vascoguita/fmc-delay-1ns-8cha/README.md

<!--
SPDX-FileCopyrightText: 2022 CERN (home.cern)

SPDX-License-Identifier: CC-BY-SA-4.0+
-->

This repo contains the full source code (hardware + gateware + software) for the FmcDelay1ns4cha FMC module.
