vascoguita/fmc-delay-1ns-8cha/doc/index.rst

Welcome to Fmc Fine-Delay Software's documentation!
===================================================

.. toctree::
   :maxdepth: 2
   :caption: Contents:

   introduction
   installation
   driver
   library
   tools
   developer-info
   troubleshooting
