vascoguita/fmc-delay-1ns-8cha/hardware/doc/long-term-report/drawings/delay_vs_temp.pdf

0

0.2

65.6 | 65.8 | 66 | 66.2 | 66.4 | 66.6 | 66.8 | 67

Delay error [ns]

Temperature [deg C]

Delay error
