vascoguita/fmc-delay-1ns-8cha/hardware/doc/long-term-report/drawings/jitter_histogram.pdf

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
-0.5 | -0.3 | -0.1 | 0.1 | 0.3 | 0.5

Sample count

Time [ns]

Error wrs to 700 ns setpoint
