vascoguita/fmc-delay-1ns-8cha/hardware/doc/design-notes/drawings/output_shape.png

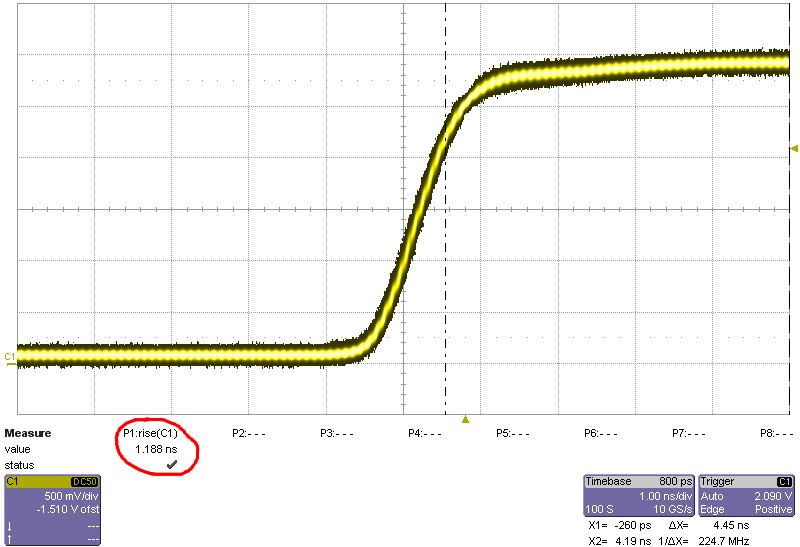
hardware/doc/design-notes/drawings/output_shape.png
