vascoguita/fmc-delay-1ns-8cha/hardware/doc/design-notes/drawings/top_level.png

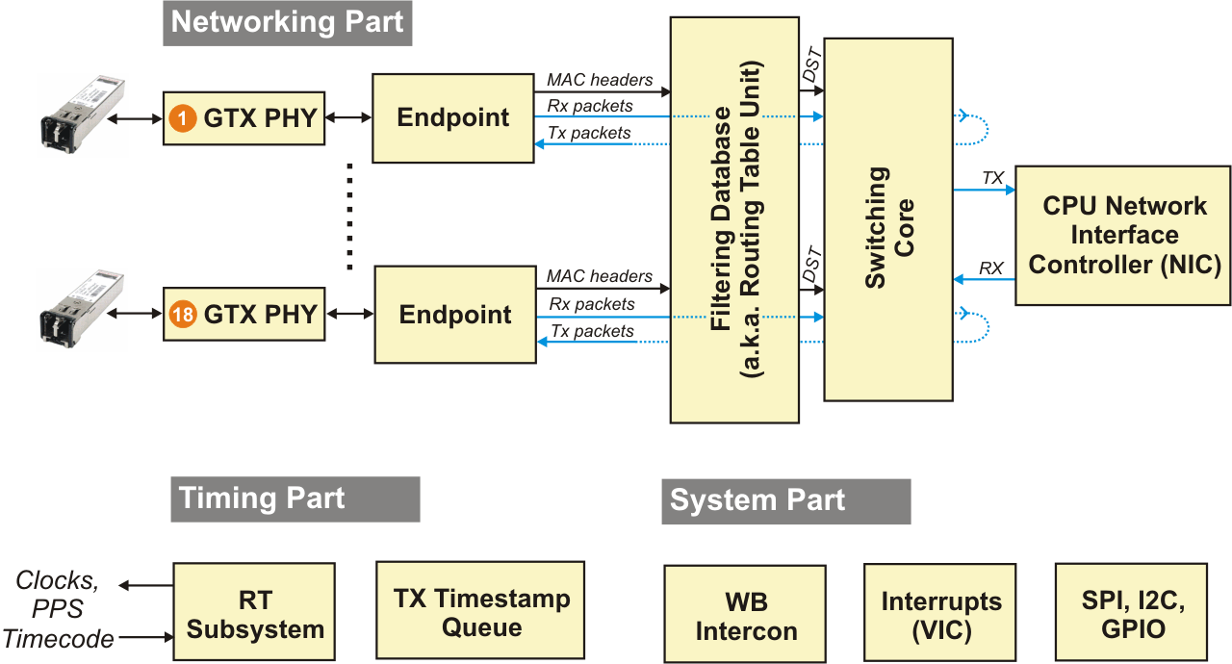
hardware/doc/design-notes/drawings/top_level.png
