vascoguita/fmc-delay-1ns-8cha/hardware/mechanical/heatsink/FMC-Delay Heatsink.stp

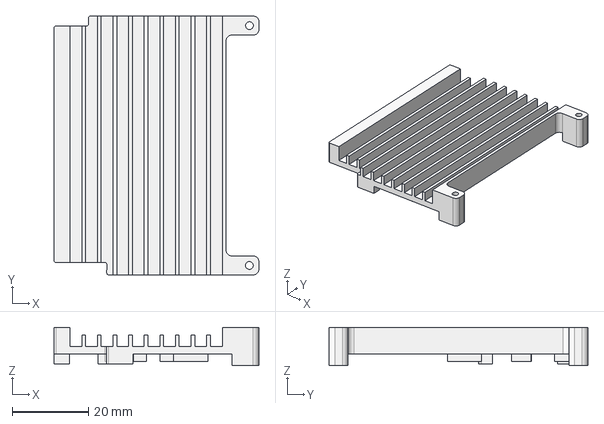
[picture p3: CAD file, 2014-09-23]
hardware/mechanical/heatsink/FMC-Delay Heatsink.stp
53.9 x 68.0 x 10.0 mm
