vascoguita/fmc-delay-1ns-8cha/(list of files, cad)

Other CAD files:
hardware/mechanical/heatsink/FMC-Delay Heatsink.dxf
hardware/mechanical/heatsink/FMC-Delay Heatsink.igs
