vascoguita/fmc-delay-1ns-8cha/hardware/doc/long-term-report/drawings/plot_average.pdf

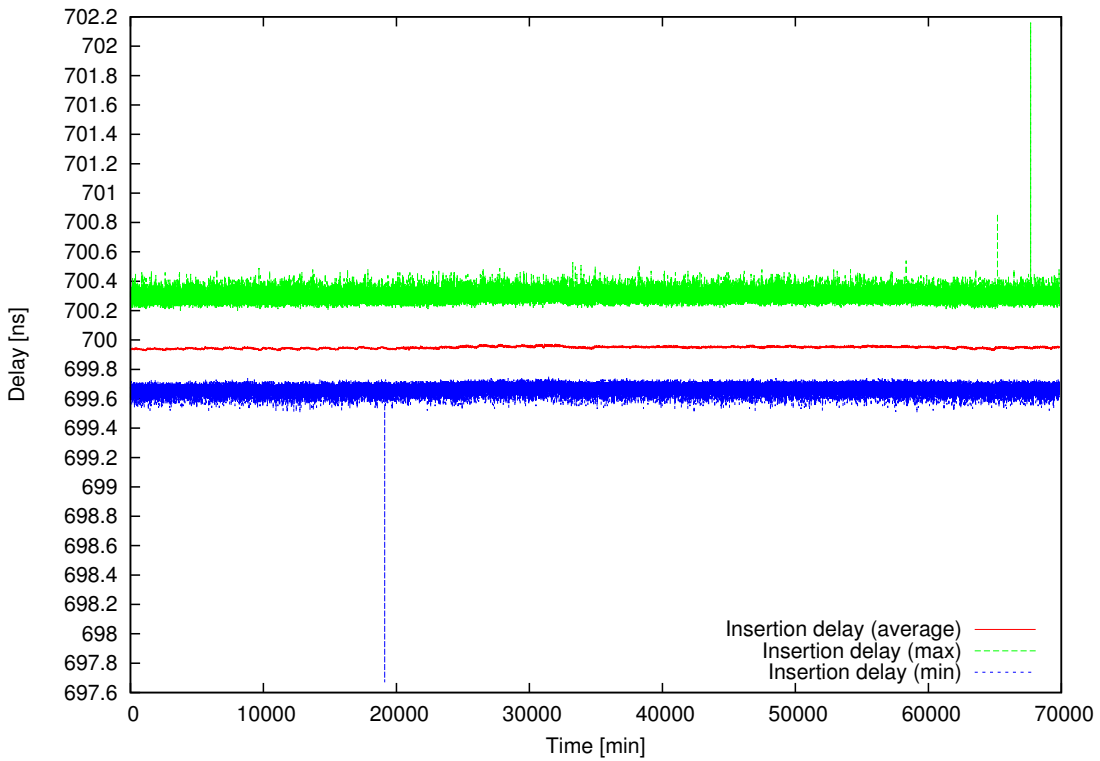
[picture p4: page 1]
Delay [ns]; Time [min]

Insertion delay (average)
Insertion delay (max)
Insertion delay (min)
