vascoguita/fmc-delay-1ns-8cha/hardware/doc/long-term-report/drawings/connection_diagram.pdf

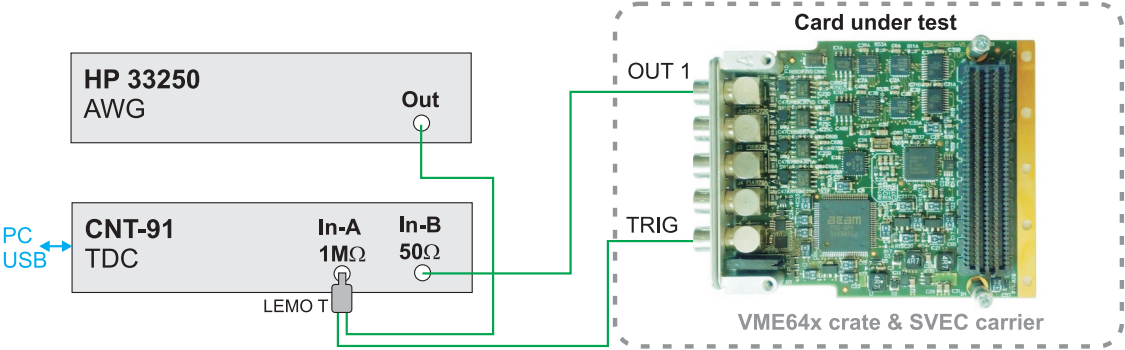
[picture p5: page 1]
