vascoguita/fmc-delay-1ns-8cha/hardware/doc/design-notes/drawings/block_diagram.pdf

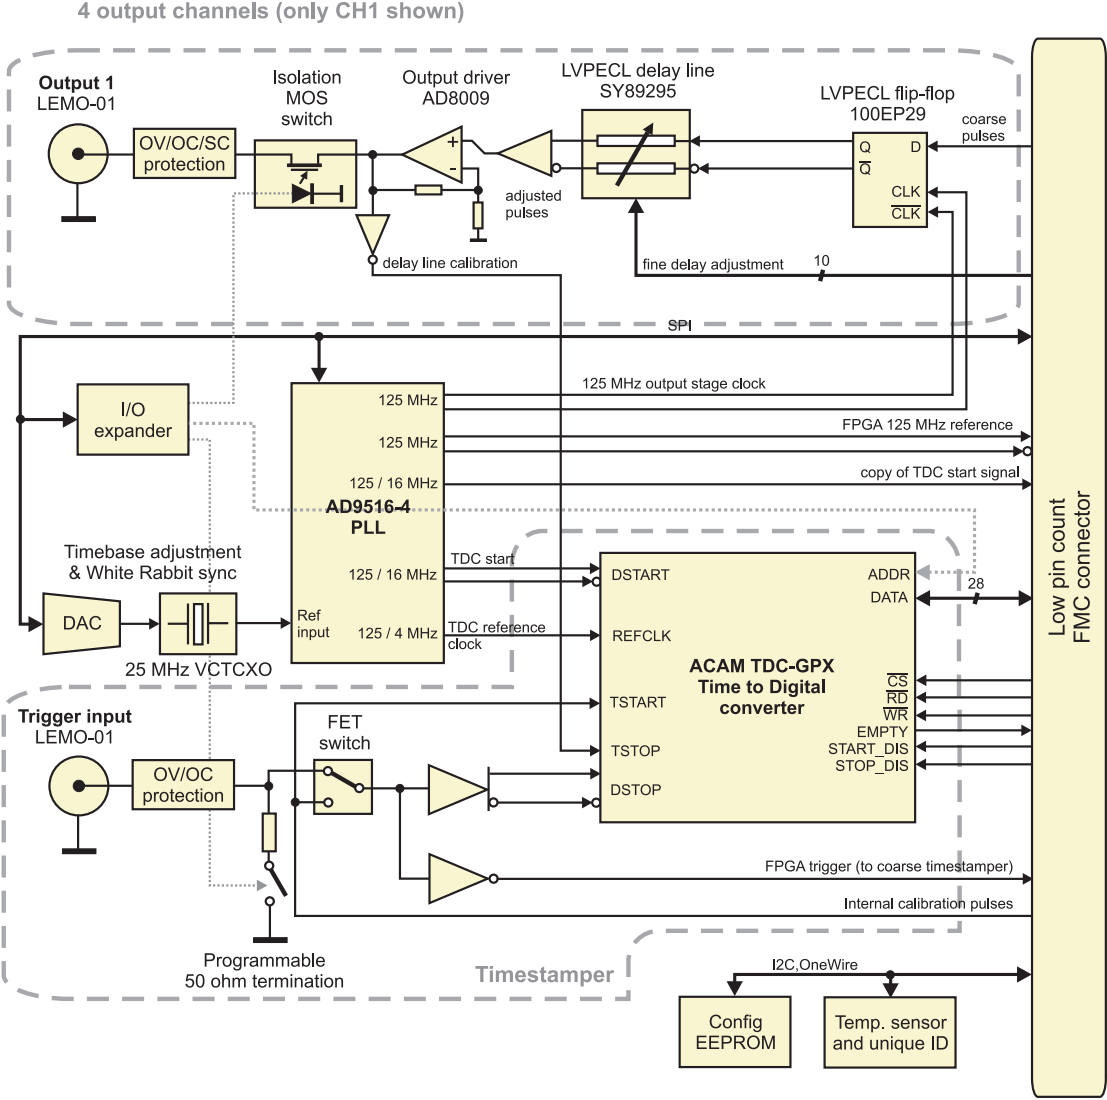
[picture p6: page 1]
