vascoguita/fmc-delay-1ns-8cha/hardware/doc/design-notes/drawings/calib_why.pdf

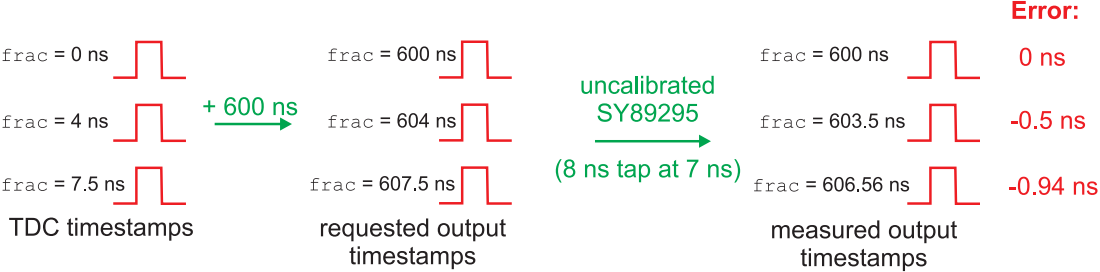
[picture p7: page 1]
