vascoguita/fmc-delay-1ns-8cha/hardware/doc/design-notes/drawings/vhdl_output_stage.pdf

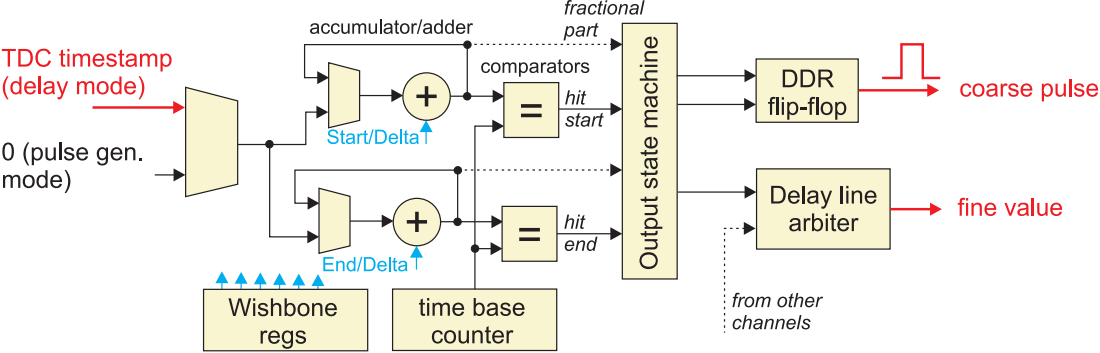
[picture p8: page 1]
