vascoguita/fmc-delay-1ns-8cha/hardware/doc/design-notes/drawings/svec_top_block.pdf

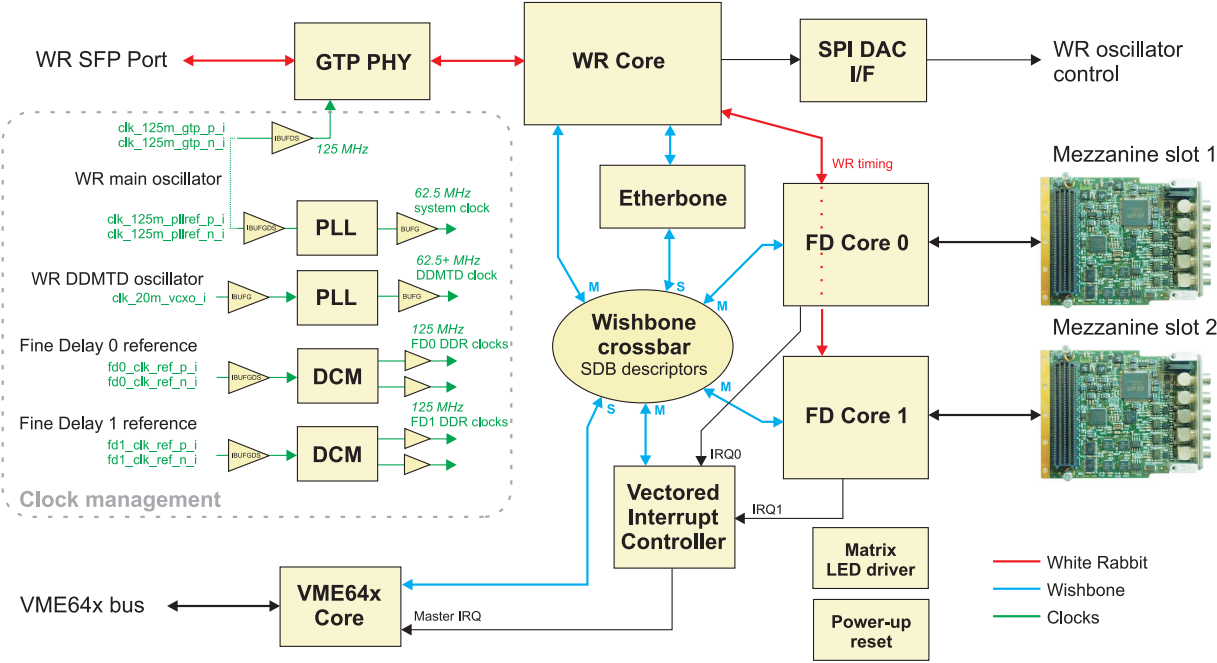
[picture p9: page 1]
