vascoguita/fmc-delay-1ns-8cha/hardware/doc/design-notes/drawings/tdc_timebase.pdf

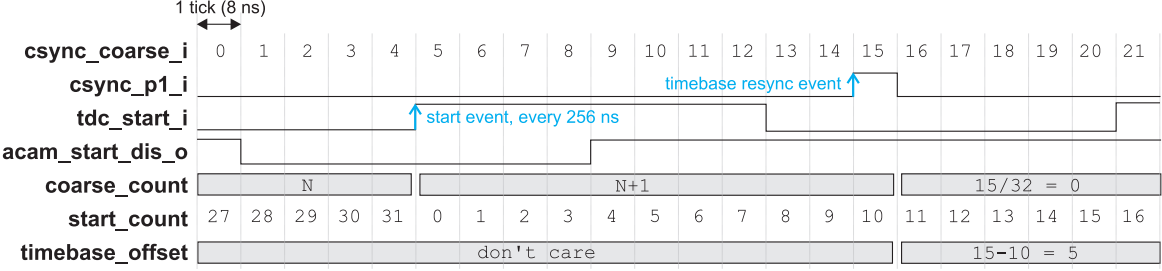
[picture p10: page 1]
