vascoguita/fmc-delay-1ns-8cha/hardware/doc/design-notes/drawings/ddmtd_calibration.pdf

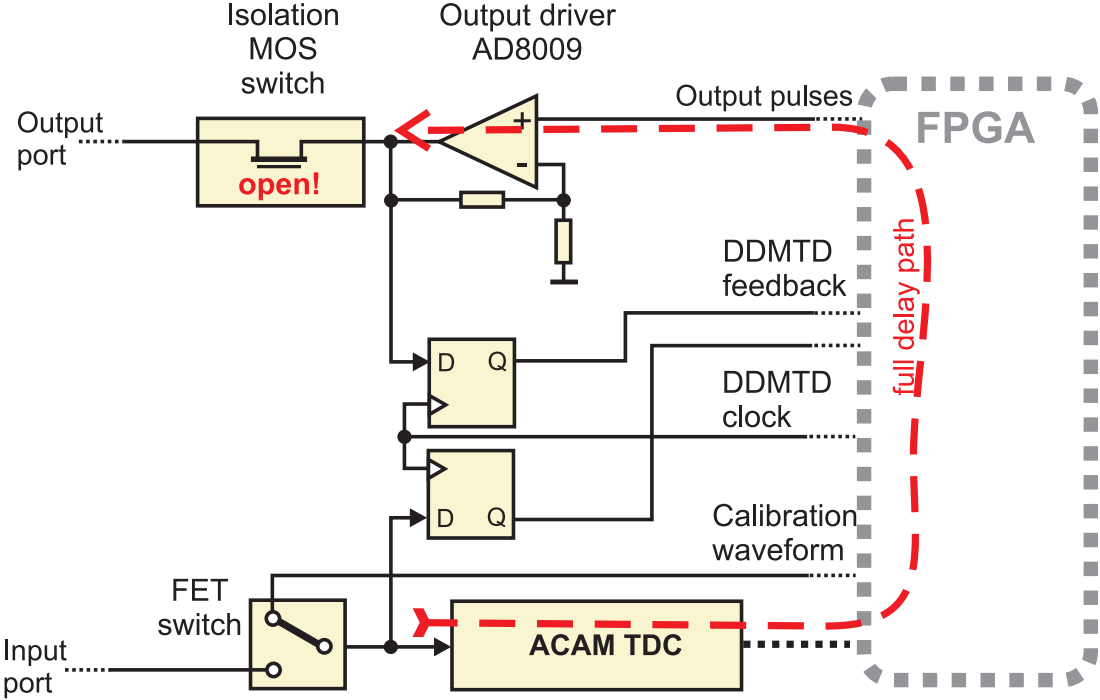
[picture p11: page 1]
