vascoguita/fmc-delay-1ns-8cha/hardware/doc/design-notes/drawings/fpga_diagram.pdf

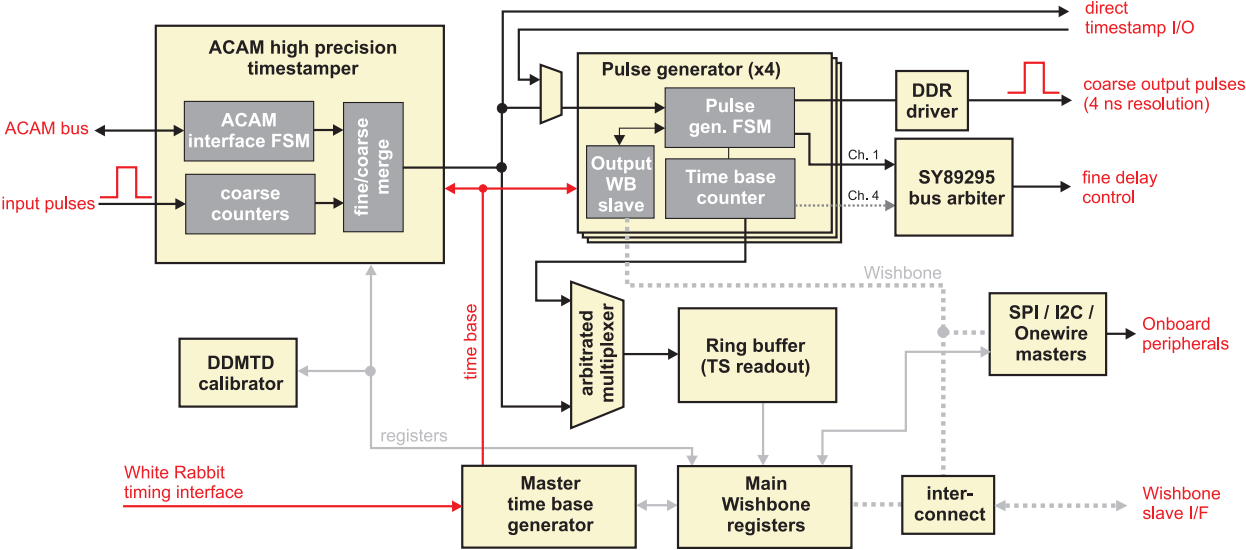
[picture p12: page 1]
