vascoguita/fmc-delay-1ns-8cha/hardware/doc/design-notes/drawings/output_calibration.pdf

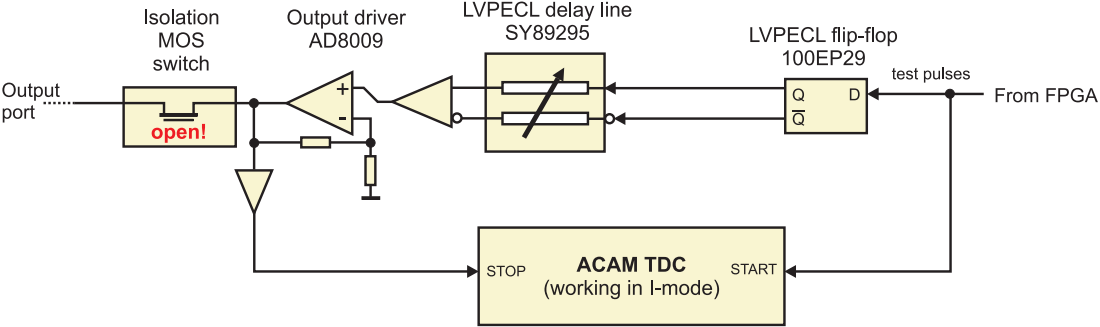
[picture p13: page 1]
