vascoguita/fmc-delay-1ns-8cha/hardware/doc/design-notes/drawings/simple_diagram.pdf

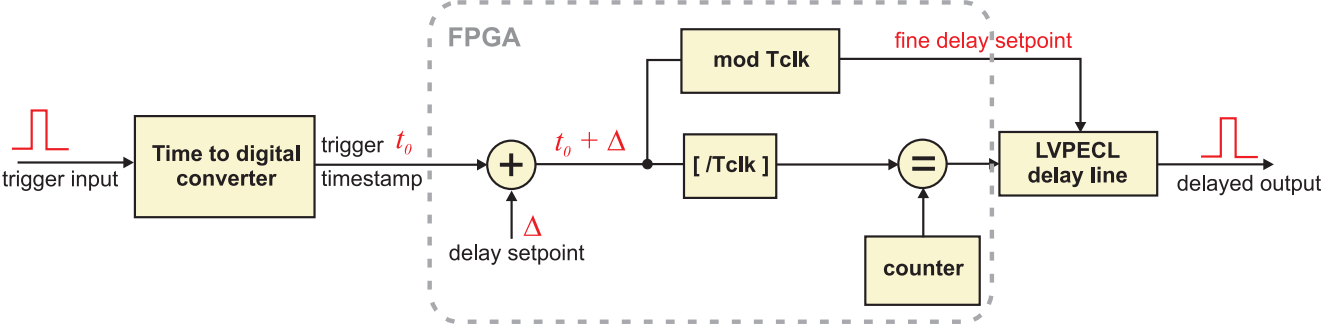
[picture p14: page 1]
