vascoguita/fmc-delay-1ns-8cha/hardware/doc/design-notes/drawings/tdc_principle.pdf

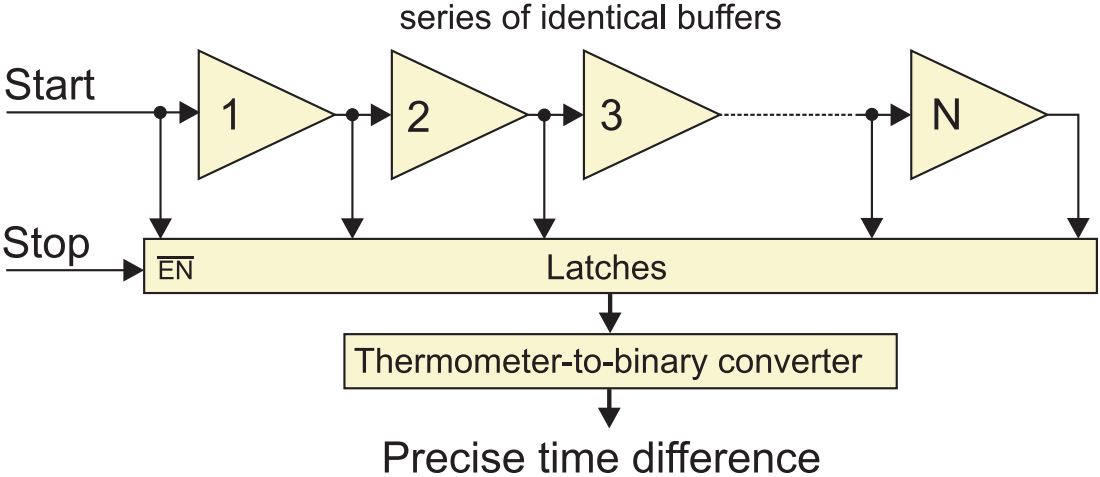
[picture p15: page 1]
