vascoguita/fmc-delay-1ns-8cha/hardware/doc/design-notes/drawings/wr_pll.pdf

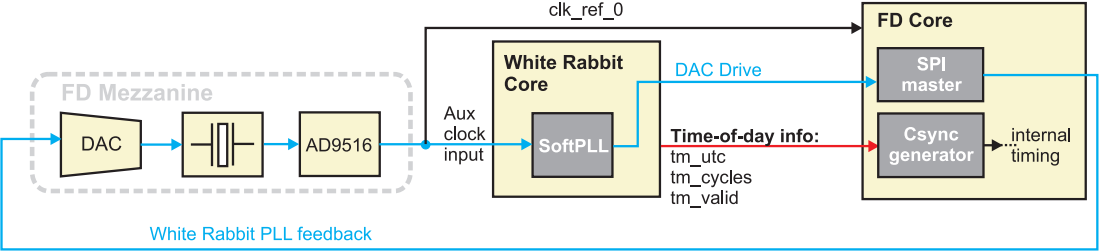
[picture p16: page 1]
