vascoguita/fmc-delay-1ns-8cha/(list of files, drawings)

Other design files:
hardware/circuit_board/EDA-02267-V6-1_project.PrjPCB
hardware/circuit_board/Schematics/acam_tdc.SchDoc
hardware/circuit_board/Schematics/clock_generator.SchDoc
hardware/circuit_board/Schematics/delay_channel.SchDoc
hardware/circuit_board/Schematics/drv_single_channel.SchDoc
hardware/circuit_board/Schematics/fmc_connector.SchDoc
hardware/circuit_board/Schematics/FMC_Delay_1ns_4Cha.SchDoc
hardware/circuit_board/Schematics/input_stage.SchDoc
hardware/circuit_board/Schematics/leds_mem_sensor.SchDoc
hardware/circuit_board/Schematics/output_driver.SchDoc
hardware/circuit_board/Schematics/power_supply.SchDoc
