vascoguita/fmc-delay-1ns-8cha/hdl/testbench/spec_wr_top/Manifest.py

# SPDX-FileCopyrightText: 2022 CERN (home.cern)
#
# SPDX-License-Identifier: CERN-OHL-W-2.0+

ctrls = ["bank3_32b_32b"]
action = "simulation"
target = "xilinx"
vcom_opt="-mixedsvvh l"
fetchto = "../../ip_cores"
include_dirs = ["../../include",
                "../../ip_cores/general-cores/modules/wishbone/wb_spi/",
                "../../ip_cores/general-cores/sim/",
                "../../ip_cores/gn4124-core/hdl/sim/gn4124_bfm/",
                "../../ip_cores/general-cores/modules/wishbone/wb_lm32/src/"]
syn_device = "xc6slx45t"
sim_tool = "modelsim"
sim_top = "main"
top_module = "main"
files = ["main.sv","buildinfo_pkg.vhd","../../syn/spec/sourceid_spec_fine_delay_top_pkg.vhd"]

modules = {"local":  ["../../top/spec",    "../../ip_cores/gn4124-core/hdl/sim/gn4124_bfm/" ]}

#try:
exec(open(fetchto + "/general-cores/tools/gen_buildinfo.py").read())
#except:
#  pass
