vascoguita/fmc-delay-1ns-8cha/hdl/testbench/adder_test/Manifest.py

# SPDX-FileCopyrightText: 2022 CERN (home.cern)
#
# SPDX-License-Identifier: CERN-OHL-W-2.0+

action = "simulation"

vlog_opt="+incdir+../../include"

files = ["main.sv", "../../rtl/fd_ts_adder.vhd"];
#files = "../modules = {"local": [ "../../rtl" ] }
