vascoguita/fmc-delay-1ns-8cha/(commit log)

2011-08-29 Separated reset generation from the top-level core
    [fd_reset_generator.vhd]
2011-08-29 Separated GPIO port driver from the top-level core
2011-08-29 fd_acam_timestamper: pipelined post-processing, replaced some constants with host-driven registers
    [fd_acam_timestamper.vhd]
2011-08-31 fd_reset_generator: naming fixes after moving the code to a separate unit
    [fd_reset_generator.vhd]
2011-08-31 fd_acam_timestamper: moved some code to separate units, fixed a bug causing coarse timestamp to be sometimes gathered before the ACAM gets enabled
    [fd_acam_timestamper.vhd]
2011-09-06 Sch/PCB: Initial upload
    [CHANNEL_DELAY.SchDoc, FMC connector.SchDoc, FMC_Delay_1ns_4Cha.PrjPcb, FMC_Delay_1ns_4Cha.SchDoc, INPUT_LOGIC.SchDoc, TDC.SchDoc, clock_generator.SchDoc]
2011-09-06 Sch/PCB: wip 1
    [CHANNEL_DELAY.SchDoc, FMC connector.SchDoc, FMC_Delay_1ns_4Cha.PrjPcb, FMC_Delay_1ns_4Cha.SchDoc, INPUT_LOGIC.SchDoc, LED_MEM.SchDoc, OUTPUT_BUFFER.SchDoc, TDC.SchDoc]
2011-09-06 Sch/PCB: wip 2
    [FMC connector.SchDoc, FMC_Delay_1ns_4Cha.PrjPcb, clock_generator.SchDoc]
2011-09-06 Sch/PCB: wip 3
    [CHANNEL_DELAY.SchDoc, FMC connector.SchDoc, FMC_Delay_1ns_4Cha.PrjPcb, FMC_Delay_1ns_4Cha.SchDoc, INPUT_LOGIC.SchDoc, LED_MEM.SchDoc, OUTPUT_BUFFER.SchDoc, TDC.SchDoc]
2011-09-06 Sch/PCB: wip 4
    [CHANNEL_DELAY.SchDoc, FMC_Delay_1ns_4Cha.SchDoc, INPUT_LOGIC.SchDoc, LED_MEM.SchDoc, OUTPUT_BUFFER.SchDoc, TDC.SchDoc, power_supply.SchDoc]
2011-09-06 Sch/PCB: wip 5
    [CHANNEL_DELAY.SchDoc, FMC connector.SchDoc, FMC_Delay_1ns_4Cha.PrjPcb, FMC_Delay_1ns_4Cha.SchDoc, INPUT_LOGIC.SchDoc, LED_MEM.SchDoc, OUTPUT_BUFFER.SchDoc, TDC.SchDoc]
2011-09-06 Sch/PCB: ReviewFineDelayFMC10112010 Improvements
    [CHANNEL_DELAY.SchDoc, FMC connector.SchDoc, FMC_Delay_1ns_4Cha.SchDoc, INPUT_LOGIC.SchDoc, LED_MEM.SchDoc, OUTPUT_BUFFER.SchDoc, TDC.SchDoc, clock_generator.SchDoc]
2011-09-06 Sch/PCB: Fixed wrong component annotation
    [CHANNEL_DELAY.SchDoc, FMC_Delay_1ns_4Cha.PrjPcb, FMC_Delay_1ns_4Cha.SchDoc, INPUT_LOGIC.SchDoc, LED_MEM.SchDoc, OUTPUT_BUFFER.SchDoc, TDC.SchDoc, clock_generator.SchDoc]
2011-09-06 Sch/PCB: Updated PDF version
2011-09-06 Sch/PCB: Added directory with PLL loop ADIsim project file, changed clk assignments at the PLL output, added extra notes, changed termination resistors
    [FMC connector.SchDoc, FMC_Delay_1ns_4Cha.PrjPcb, FMC_Delay_1ns_4Cha.SchDoc, INPUT_LOGIC.SchDoc, TDC.SchDoc, clock_generator.SchDoc]
2011-09-06 Sch/PCB: wip
2011-09-06 Sch/PCB: New PDF file
2011-09-06 Sch/PCB: First PCB release, some minor SCH bugs fixed
    [CHANNEL_DELAY.SchDoc, FMC connector.SchDoc, FMC_Delay_1ns_4Cha.PrjPcb, FMC_Delay_1ns_4Cha.SchDoc, INPUT_LOGIC.SchDoc, OUTPUT_BUFFER.SchDoc, TDC.SchDoc, clock_generator.SchDoc]
2011-09-06 Sch/PCB: Changed clock connection to the output flip-flops, changed resistors to resistor arrays, added 2 layers to improve signal integrity and differential pair routing, changed footprints and sche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
    [CHANNEL_DELAY.SchDoc, FMC connector.SchDoc, FMC_Delay_1ns_4Cha.PrjPcb, FMC_Delay_1ns_4Cha.SchDoc, INPUT_LOGIC.SchDoc, OUTPUT_BUFFER.SchDoc, TDC.SchDoc, clock_generator.SchDoc]
2011-09-06 Sch/PCB: Added CERN/OHWR notice, updated copyright and stackup info, added script for PDF generation
    [FMC_Delay_1ns_4Cha.PrjPcb]
2011-09-06 Sch/PCB: Uploaded new PDF with schematics and PCB
2011-09-06 Sch/PCB: V1 PCB layout + gerbers uploaded
    [FMC connector.SchDoc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]
2011-09-06 Sch/PCB: Updated pad stacks to fit PCB manufacturer's minimum IAR requirement. Removed 0-sized apertures from fiducials.
    [FMC_Delay_1ns_4Cha.DRL, FMC_Delay_1ns_4Cha.GBL, FMC_Delay_1ns_4Cha.GBO, FMC_Delay_1ns_4Cha.GBP, FMC_Delay_1ns_4Cha.GBS, FMC_Delay_1ns_4Cha.GM1, FMC_Delay_1ns_4Cha.GTL, FMC_Delay_1ns_4Cha.GTO]
2011-09-06 Sch/PCB: Bugfixes in schematics and PCB. Release for DEM.
    [CHANNEL_DELAY.SchDoc, FMC connector.SchDoc, FMC_Delay_1ns_4Cha.PrjPcb, FMC_Delay_1ns_4Cha.SchDoc, INPUT_LOGIC.SchDoc, LED_MEM.SchDoc, OUTPUT_BUFFER.SchDoc, TDC.SchDoc]
2011-09-06 Sch/PCB: Uploaded sch + pcb of V2 for review
    [CHANNEL_DELAY.SchDoc, FMC connector.SchDoc, FMC_Delay_1ns_4Cha.PrjPcb, FMC_Delay_1ns_4Cha.SchDoc, INPUT_LOGIC.SchDoc, LED_MEM.SchDoc, OUTPUT_BUFFER.SchDoc, TDC.SchDoc]
2011-09-06 Sch/PCB: V2 release for DEM
    [CHANNEL_DELAY.SchDoc, FMC connector.SchDoc, FMC_Delay_1ns_4Cha.SchDoc, INPUT_LOGIC.SchDoc, LED_MEM.SchDoc, OUTPUT_BUFFER.SchDoc, TDC.SchDoc, clock_generator.SchDoc]
2011-09-06 Sch/PCB: Added CSV with SPEC 1.1/2.0 pin assignment
    [fine_delay_pins_spec.csv, fine_delay_pins_spec.ods]
2011-09-06 Adapted directory structure to OHWR standard
    [CHANNEL_DELAY.SchDoc, FMC connector.SchDoc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]
2011-09-06 Sch/PCB: V2 release synced with EDMS
    [CHANNEL_DELAY.SchDoc, EDA-02267-V2-0_project.PrjPCB, FMC connector.SchDoc, FMC_Delay_1ns_4Cha.PrjPcb, FMC_Delay_1ns_4Cha.SchDoc, INPUT_LOGIC.SchDoc, LED_MEM.SchDoc, OUTPUT_BUFFER.SchDoc]
2011-10-27 fd_acam_timestamper: now generates calibration start pulses even if BYPASS=1, extended host read timing to avoid SI problems
    [fd_acam_timestamper.vhd]
2011-10-27 fd_delay_channel_driver: fixed possible FSM hang when the card is disabled during generation of a pulse, implemented new calibration scheme
    [fd_delay_channel_driver.vhd]
2011-10-27 fd_delay_line_arbiter: extended delay line write pulse to avoid SI problems
    [fd_delay_line_arbiter.vhd]
2011-10-27 fd_wishbone_slave: added new calibration registers
2011-10-27 fine_delay_core: new calibration scheme
2011-10-28 added WR timecode input and aux clock PLL control signals. Changed SPI core to custom module with hw arbitration of the PLL DAC access
2011-10-31 updated the top level module with new i2c master connections
2011-10-31 fd_acam_timestamp_postprocessor.vhd: added extra pipline stage to improve FPGA timing
2011-10-31 fine_delay_core.vhd: replaced the OC SPI master with a custom verrsion with HW arbitration
    [fine_delay_core.vhd]
2011-11-10 HDL: fd_acam_timestamper: extended read pulses to avoid SI problems
    [fd_acam_timestamper.vhd]
2011-11-10 HDL: fd_delay_channel_driver.vhd: re-arm the TDC if the output is disabled during pulse generation
2011-11-10 HDL: fd_spi_dac_arbiter.vhd: fixed missing readouts
    [fd_spi_dac_arbiter.vhd]
2011-11-10 HDL: fd_spi_master: change MOSI status and sample MISO in between SCK edges
2011-11-10 fine_delay_core: added bitbanged I2C master and appropriate control registers
2012-02-26 hdl: renamed timing components to avoid conflicts with wr-cores
    [Manifest.py, fd_dmtd_insertion_calibrator.vhd, fd_dmtd_with_deglitcher.vhd, fd_hpll_period_detect.vhd]
2012-02-26 hdl: missing signal fix
    [fine_delay_core.vhd, fine_delay_pkg.vhd]
2012-02-26 hdl: assignment size bug fixed
    [Manifest.py, fd_dmtd_insertion_calibrator.vhd, spec_top.vhd]
2012-02-27 software: added onewire master and DS18XXX driver
2012-02-28 V4 PCB design uploaded (minor fixes wrs the V3)
    [CHANNEL_DELAY.SchDoc, EDA-02267-V2-0_project.PrjPCB, EDA-02267-V4-0.PrjPcb, FMC connector.SchDoc, FMC_Delay_1ns_4Cha.SchDoc, INPUT_LOGIC.SchDoc, LED_MEM.SchDoc, OUTPUT_BUFFER.SchDoc]
2012-02-29 software: added pulse generator mode, temperature calibration program and PPS/10MHz demo program
2012-02-29 hdl: fd_delay_channel_driver.vhd: fixed RCR.CONT bit detection (now the core can produce continuous waveforms)
    [fd_delay_channel_driver.vhd]
2012-02-29 hdl/fd_main_wishbone_slave: added DBGOUT register for Peltier PWM control
2012-04-04 software: added missing MCP23S17 reg definition
    [fdelay_private.h]
2012-04-11 hdl/rtl/fd_acam_timestamper.vhd: disable STOP input during processing of the pulse to avoid overloading the TDC FIFO when the stop input is driven with a very fast train of pulses
    [fd_acam_timestamper.vhd]
2012-04-11 software/include/fdelay_private.h: added CS_DAC SPI device select flag
2012-04-26 software: updated python demo to work with the newest rawrabbit driver
2012-04-30 hdl/rtl/fd_ring_buffer.vhd: fixed invalid DPRAM clock connection
    [Manifest.py, fd_ring_buffer.vhd, fdelay_lib.h, main.sv]
2012-04-30 hdl/rtl/fd_delay_line_arbiter.vhd: drive delay_len_o inactive upon reset
    [fd_delay_line_arbiter.vhd]
2012-04-30 hdl/rtl/fine_delay_core.vhd: removed unused signals, wired the IRQ output line
2012-04-30 hdl/rtl/fd_csync_generator.vhd: clear DMTD status on reset
    [fd_csync_generator.vhd]
2012-05-01 hdl/rtl/fd_ring_buffer: fixed ugly readout bug
    [fd_ring_buffer.vhd]
2012-05-16 software/lib: normalize negative timestamps, SPI idle fix
    [fdelay_private.h]
2012-05-18 software/lib/pp.conf: my current test config
2012-05-22 rtl/fd_acam_timestamper: raw readout mode, protection against glitches on falling edge in case of input diode clamping, 180-deg shadow counters for debugging
    [fd_acam_timestamper.vhd]
2012-06-05 software: bugfixes in raw readout mode (enabled by default)
    [fdelay_lib.h]
2012-06-06 Added DDMTD calibration program, reorganized software directory structure, removed warnings
2012-06-06 hdl/rtl/fine_delay_core: wired new DDMTD calibrator
2012-06-06 hdl/rtl/fine_delay_pkg.vhd: fine-tuned DDMTD calibrator parameters, updated components
2012-06-08 software/python: library based on SPEC driver
2012-08-13 include: lots of fixes in simulation models (for VME top level)
    [sn74vmeh22501.v]
2012-08-13 rtl/fine_delay_core.vhd: increase SPI clock speed for system-level simulation
2012-09-21 hdl/top/spec: added power-on-reset generator that works both in PCIe and standalone mode
2012-09-25 fdelay_lib.h: fix timestamp structure layout to keep python compatibility
    [fdelay_lib.h]
2012-10-17 hdl/syn/spec: top level with VIC interrupt controller, removed spaces from SDB name
2012-10-24 hdl/top/svec: top level: new VME64x core, interrupts and Etherbone slave name fix
2012-10-24 hdl/rtl/fd_main_wishbone_slave: fix TS buffer interrupt polarity
2012-12-14 hdl/rtl/fd_main_wishbone_slave.vhd: I2C outputs should be set to ones upon reset
2012-12-14 hdl/top/svec: added power-up reset
2013-02-18 acam: work in G mode instead of R mode (appears to fix 1.5 ns bug)
    [acam_gpx.h, fdelay_private.h]
2013-02-18 onewire.c: ugly fix for invalid 1st temperature readout
2013-02-23 hdl/rtl/fd_acam_timestamper: reset FIFO after each sample
    [fd_acam_timestamp_postprocessor.vhd, fd_acam_timestamper.vhd]
2013-04-25 hdl/rtl/fine_delay_pkg: increased DDMTD calibration pulse length to improve deglitcher operation
2013-05-17 hdl/rtl/fine_delay_pkg: updated SDB version to 3, to allow the driver to distinguish between buggy (R-mode) and correct (G-mode) firmwares
    [fine_delay_pkg.vhd]
2013-05-17 hdl/top/svec: slot order according to the front panel. SDB addresses in ascending order. Fixed wrong WR Core SDB bridge address.
2013-05-21 hdl/top/svec: revert to master branch of wr-cores (1 WR slot support)
2013-06-06 top/spec/wr: temporary revert to older WR Core timing interface
    [spec_top.vhd]
2013-06-11 hdl/top/svec: support for SVEC front panel LEDs displaying WR/VME status
2013-07-04 hdl/rtl: fix unclear timebase offset signal name
    [fd_acam_timestamp_postprocessor.vhd, fd_acam_timestamper.vhd]
2014-03-11 kernel: VIC interupt support via SPEC/SVEC drivers.
    This patch unifies VIC interrupt handling by removing VIC support code from the driver
    and using the one provided by the carrier. Since the SVEC now supports IRQs too, both
    carriers can benefit from interrupts.
2014-03-17 hdl/rtl/fd_spi_dac_arbiter.vhd: mask WR Core DAC write signal with TCR.WR_ENABLE bit
    This prevents the WR Core from messing up with the FD DAC settings when an incorrect
    WRC firmware is loaded.
    [fd_spi_dac_arbiter.vhd]
2014-03-18 lib: add casts to stdint-typed printf arguments
    The usual boring stuff to shut up the compiler warnings like
    fdelay-read.c:57: warning: format ‘%lli’ expects type ‘long long int’,
    but argument 3 has type ‘uint64_t’
2014-03-18 fix off-by-one error in rep count readback
    [fd-zio.c]
2014-03-18 doc: multiple fixes
    - API changes for the latest driver (retreiving output configuration)
    - updated info on gateware installation
    - dropped 2.6.24 support
    - consistency fixes (Time-stamps -> timestamps, etc.)
    - moved raw I/O info into an appendix for developers.
2014-03-20 moved tools to oldtools; tools/ is currently empty
2014-03-24 tools: add fmc-fdelay-board-time
2014-03-24 bugfix: lib: read was overwriting first sample instead of filling the array
2014-03-24 kernel/fd-zio.c: WR support improvements - more accurate error/status reporting in wr_mode/query_wr_mode - prevent changing the board time when WR is on
    n Please enter the commit message for your changes. Lines starting
    [fd-zio.c]
2014-03-24 tools/fmc-fdelay-board-time: more verbose help, show WR status
2014-03-24 tools/fmc-fdelay-term: minor bugfixes - fix termination status printing (was showing null) - error handling when setting termination
2014-03-24 tools/fmc-fdelay-status: report both human readable and raw
    Additionally, document the effect of delay-offset calibration parameter
    in the read-back of values.
2014-03-24 tools: report output config/status in both human and raw mode, depending on command line switch
2014-03-24 hdl/rtl/fd_delay_line_arbiter.vhd: rewritten for faster arbitration to never miss 600 ns deadline
    The commit also adds possibility of wiring the channel driver 0 and ACAM data valid strobes/state indication
    to the front panel LEMO connectors on the SVEC carrier, for the purpose of debugging ACAM/output stage processing latency.
2014-03-24 driver: fix use of TDC user_offset at interrupt time
    TDC user offset should be applied to all timestamps. The code, however,
    didn't do that properly, and fast_tdc mode was missing it.
    Now user_offset is applied where the hardware offset is, like it should
    have since time zero.
    This should have no effect, as user_offset is an option nobody used
    so far, as far as we know.
    [fd-irq.c]
2014-04-10 kernel/fd-zio.c: fix incorrect readout of repeat count if output configured in infinite repetition mode
    [fd-zio.c]
2014-04-10 kernel/fd-zio.c: if the output is DISABLED, still write the settings, applying DELAY mode offsets.
    This is a hotfix for the COHAL/FESA guys: the current driver/lib does not decouple
    enabling/disabling the output and setting its mode (pulse/delay). Previously, disabling the output
    was leading to loss of its configuration. This patch allows to retain it under the condition that the
    output is only switched between DISABLED and DELAY modes.
2014-04-10 tools/fmc-fdelay-pulse: make output channel option mandatory.
    This fixes a potentially very dangerous behaviour: previously the output was defaulted to channel 1 and
    running fmc-fdelay-pulse with no parameters by unaware user would result with generation of a 10 Hz
    waveform on output 1.
2014-04-14 fd_zio_output: moved sanitization of input arguments to userspace library.
    Reason: zio block the channel if the raw_io function returns an error (possibly
    a bug in zio user trigger handling).
    [fd-zio.c]
2014-05-27 circuit_board: synced with EDMS V6.0 release
    [EDA-02267-V4-0.PrjPcb, EDA-02267-V6-0_project.PrjPCB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]
2014-06-12 sdb-lib: remove is unecessary now, is part of fmc-bus
    Actually, it reverts c92af50f795ee3d03000ec3bd6e046b44a84cd73 and
    pick the files directly from the fmc-bus project
    Acked-by: Alessandro Rubini <rubini@gnudd.com>
    [calibration.c]
2014-07-14 kernel: fix mem leakage
    [fd-core.c, fd-irq.c]
2014-07-16 kernel: add comment to explain interrupt
    Explain why the handler doesn't clear the interrupt in EIC_ISR even if
    the documentation regarding this register is saying something different.
    [fd-irq.c]
2014-07-16 kernel: configure only what is necessary
    This prevent confusion while reading the code because, for example, a
    question: why initialize both timer and tasklet if we can use only one, and
    we cannot change the configuration at run-time?
    fd_irq_init:
    setup_timer only if the user requires timer mode, otherwise initialize tasklet
    [fd-irq.c]
2014-07-16 kernel: disable irq before register handler
    In order to avoid spurious interrupts from previous running, disable all
    interrupts before registering the IRQ handler.
    [fd-irq.c]
2014-07-28 kernel/calibration.c: sdbfs_open_id endianess correction
    This is needed because another project builds this file for the lm32,
    which is big-endian. This makes no effect on the PC.
    [calibration.c]
2014-08-22 kernel: add comments to explain driver behavior
2014-09-23 mechanical: heatsink design files
    [FMC-Delay Heatsink.dxf, FMC-Delay Heatsink.igs, FMC-Delay Heatsink.stp]
2015-02-02 circuit_board: synced with EDMS V6.1 release
    [EDA-02267-V6-0_project.PrjPCB, EDA-02267-V6-1_project.PrjPCB, FMC_Delay_1ns_4Cha.SchDoc, acam_tdc.SchDoc, clock_generator.SchDoc, delay_channel.SchDoc, drv_single_channel.SchDoc, fmc_connector.SchDoc]
2015-02-23 kernel: fixed SDB enumeration for gatewares containing different mezzanine cores
    [fd-core.c, fine-delay.h, onewire.c]
2015-03-24 kernel: reduce driver verbosity
2015-05-04 kernel: get carrier module to prevent rmmod
    [fd-core.c]
2015-08-28 tools: fix gcc warnings
    [fd-core.c]
2015-12-01 tools: add printing version of repo
    with -V switch
2018-08-17 hdl: use dual reset async fifos and pulse synchronizers to help with meeting timing
    [fd_csync_generator.vhd, fd_ring_buffer.vhd, fine_delay_core.vhd]
2019-04-02 hdl: don't sample start with the falling clock edge
2019-09-09 kernel: replace FMC with platform
    [calibrate.c, calibration.c, fd-core.c, fd-irq.c, fd-zio.c, fine-delay.h, gpio.c, onewire.c]
2019-09-11 drv: bugfix release resources on remove and on error
    [fd-core.c]
2019-09-12 sw:drv: FMC slot information comes from FPGA
2019-09-12 sw:drv: improve irq_request error message
    [fd-irq.c]
2019-09-12 sw:drv: add top-level driver for SPEC
2019-09-18 sw:drv: reviw EEPROM calibration code
2019-09-18 sw:drv: fix error condition by removing superflous variable
    [fd-core.c]
2019-09-18 sw:drv: remove unimplemented prototypes
2019-09-18 sw:tools: add calibration read/write tool
2019-09-19 sw:drv: fix exit from calibration on error
    [fd-core.c]
2019-09-26 sw:drv: add top-level driver for SVEC double fine delay
2019-09-29 [hdl] one extra register stage to help with timing in timestamp postprocessor
2019-10-15 drv: fix svec-fine-delay ID
    [fmc-fine-delay-svec-core.c]
2019-12-18 sw:drv: update top level driver IDs
2020-05-13 drv: do not use MFD to register device
2020-05-18 lib: do not accept index to open device
2020-05-19 doc: update driver
2020-05-25 convention: moved hardware to separate directory
    [EDA-02267-V6-1_project.PrjPCB, FMC-Delay Heatsink.dxf, FMC-Delay Heatsink.igs, FMC-Delay Heatsink.stp, FMC_Delay_1ns_4Cha.SchDoc, acam_tdc.SchDoc, clock_generator.SchDoc, delay_channel.SchDoc]
2020-05-27 bld: do not build pre-requirements in real installations this does not work
    while this is handy and useful for personal use or a quick start, this
    is confusing and problematic for real installations. For this reason I
    remove the handy quick-start Makefile rules. People should know how to
    build software if they download the sources. Ideally we should deliver
    binaries for a set of Linux distributions or DKMS packages for drivers.
2020-05-27 sw:bld: clean/install calibration tool
2020-05-27 sw: show calibration tool version
2020-09-25 sw:drv: do not register FD if no mezzanine
    If the FMC Delay mezzanine is not present, then there is no reason to
    register its instance. Actually, it could be risky because the driver
    may do actions that could compromise the FPGA configuration.
2020-10-07 sw:drv: add parent to hw ZIO device
2020-12-02 hdl: correct generation of source ids
    [Manifest.py, spec_fine_delay_top.vhd, svec_fine_delay_top.vhd]
2020-12-03 hdl: fixed version register layout to match specification
    [spec_fine_delay_top.vhd, svec_fine_delay_top.vhd]
2020-12-04 sw:drv: fix IPMI fru header file
    [fd-core.c]
2020-12-04 sw:drv: add link to FMC slot in sysfs
2022-07-26 .gitignore: Don't track outputs from build
2022-07-26 kernel: timer: 'struct timespec' (32 bit) and related interfaces are deprecated
    In linux-v5.6 release:
    'struct timespec' got unsupported for in-kernel use at
    commit c766d1472c70d25ad475cf56042af1652e792b23 ("y2038: hide
    timeval/timespec/itimerval/itimerspec types")
    And accordingly, the 32 bit interfaces were also removed at
    commit 412c53a680a97cb1ae2c0ab60230e193bee86387 ("y2038: remove
    unused time32 interfaces")
    Thus, use 'struct timespec64' and related interfaces for 5.10.65 kernel.
2022-07-26 kernel: spec-core: definition of 'struct platform_device_id' no longer extractable from 'linux/platform_device.h'
    The 'struct platform_device_id' is defined in 'linux/mod_devicetable.h';
    this header was #include in 'linux/platform_device.h'. Hence, using the
    latter header-file was enough. But in linux-v4.18 at
    commit ac3167257b9fe16c9426c2087ead1c9f1b0992b1 ("headers: separate
    linux/mod_devicetable.h from linux/platform_device.h")
    the former was no more included in the latter. Thus, we need to do it
    explicitly.
    Since this change makes no difference if this driver is compiled against
    Kernel version less than v4.18, we do not need any conditional
    directives.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
    [fmc-fine-delay-spec-core.c]
2022-07-26 kernel: spec_core: Update API setup_timer() to timer_setup()
    The API was modified in linux-v4.14 at
    commit e99e88a9d2b067465adaa9c111ada99a041bef9a ("treewide:
    setup_timer() -> timer_setup()")
    In software/kernel:
    - in 'fd-irq.c', the function fd_tlet() was used for both timer and
    interrupt-tasklet.
    - this function was of type: void (func)(unsigned long).
    - both setup_timer() and tasklet_init() use this function-type as one
    of their arguments.
    - setup_timer() was updated to timer_setup() which now accepts a
    function of type void (func)(struct timer_list*).
    Thus,:
    - define fd_tlet_interrupt() of type void (func)(unsigned long).
    - define fd_tlet_timer() of type void (func)(struct time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
2022-09-14 Fix: Invalid permissions for attribute
    [fd-zio.c]
2022-09-30 software: tools: fmc-fdelay-calibration: Mark unused variable
    This warning is treated as error by the compiler. Mark it with
    "__attribute__((unused))".
2022-10-13 driver: zio: calibrate: CS7 supports newer functions.
    As per tovalds/linux, the kernel version below 4.14 support
    fd_update_calibration(unsigned long arg)
    and not
    fd_update_calibration(struct timer_list *arg)
    But even though CS7 is 3.10 based, patches might
    have been backported, and it supports the latest one.
2022-11-29 Revert "driver: zio: calibrate: CS7 supports newer functions."
    This reverts commit 25f66f51ee927951cde9d45ed68914a45f2480b9.
    Turns out that even though Red-Hat backported "timer_setup()" on CS7, it is
    not working well and corrupting the memory somewhere. Thus, we should
    stick to the API provided by vanilla kernel.
    [calibrate.c]
2022-11-29 [Fix] kernel: spec_core: Put conditional directives in header file too.
    In the commit:
    commit 02ec43ce74e015eed509305e4faad78c9a8f828a ("kernel:
    spec_core: Update API setup_timer() to timer_setup()")
    We added the newer protoype for 'fd_update_calibration()' along-with the
    older one with conditional ditrectives.
    Reflect the same changes in 'fine-delay.h' to avoid compilation error.
    [fine-delay.h]
2022-12-12 hdl: fix SVEC synthesis
    [Manifest.py]
